Ritik4388/RV32I-PIPELINED-RTL-TO-GDSII/riscv-dv/testlist.yaml

- test: riscv_arithmetic_basic_test
  description: ALU only, numeric corner cases (0, -1, MIN, MAX...)
  gen_opts: >
    +instr_cnt=5000
    +num_of_sub_program=0
    +directed_instr_0=riscv_int_numeric_corner_stream,4
    +no_fence=1 +no_data_page=1 +no_branch_jump=1
    +boot_mode=m +bare_program_mode=1 +no_csr_instr=1
    +no_ebreak=1 +no_wfi=1 +no_dret=1
  iterations: 2
  gen_test: riscv_instr_base_test
  rtl_test: core_base_test

- test: riscv_rand_instr_test
  description: random mix incl. load/store streams and branches
  gen_opts: >
    +instr_cnt=5000
    +num_of_sub_program=5
    +directed_instr_0=riscv_load_store_rand_instr_stream,4
    +directed_instr_1=riscv_loop_instr,4
    +directed_instr_2=riscv_hazard_instr_stream,4
    +directed_instr_3=riscv_load_store_hazard_instr_stream,4
    +directed_instr_4=riscv_multi_page_load_store_instr_stream,4
    +directed_instr_5=riscv_mem_region_stress_test,4
    +directed_instr_6=riscv_jal_instr,4
    +no_fence=1
    +boot_mode=m +bare_program_mode=1 +no_csr_instr=1
    +no_ebreak=1 +no_wfi=1 +no_dret=1
  iterations: 3
  gen_test: riscv_instr_base_test
  rtl_test: core_base_test

- test: riscv_jump_stress_test
  description: lots of JAL / JALR - stresses BTB and redirect logic
  gen_opts: >
    +instr_cnt=5000
    +num_of_sub_program=5
    +directed_instr_1=riscv_jal_instr,20
    +no_fence=1
    +boot_mode=m +bare_program_mode=1 +no_csr_instr=1
    +no_ebreak=1 +no_wfi=1 +no_dret=1
  iterations: 2
  gen_test: riscv_instr_base_test
  rtl_test: core_base_test

- test: riscv_loop_test
  description: nested loops - stresses the BHT counters
  gen_opts: >
    +instr_cnt=10000
    +num_of_sub_program=5
    +directed_instr_1=riscv_loop_instr,20
    +no_fence=1
    +boot_mode=m +bare_program_mode=1 +no_csr_instr=1
    +no_ebreak=1 +no_wfi=1 +no_dret=1
  iterations: 2
  gen_test: riscv_instr_base_test
  rtl_test: core_base_test

- test: riscv_rand_jump_test
  description: jumps between many sub-programs
  gen_opts: >
    +instr_cnt=10000
    +num_of_sub_program=10
    +directed_instr_0=riscv_load_store_rand_instr_stream,8
    +no_fence=1
    +boot_mode=m +bare_program_mode=1 +no_csr_instr=1
    +no_ebreak=1 +no_wfi=1 +no_dret=1
  iterations: 2
  gen_test: riscv_instr_base_test
  rtl_test: core_base_test
