Ritik4388/RV32I-PIPELINED-RTL-TO-GDSII/rtl/alu.sv

module alu
  import riscv_pkg::*;
(
  input  alu_op_e     op,
  input  logic [31:0] a, b,
  output logic [31:0] y
);
  always_comb begin
    unique case (op)
      ALU_ADD:  y = a + b;
      ALU_SUB:  y = a - b;
      ALU_SLL:  y = a << b[4:0];
      ALU_SLT:  y = {31'b0, $signed(a) < $signed(b)};
      ALU_SLTU: y = {31'b0, a < b};
      ALU_XOR:  y = a ^ b;
      ALU_SRL:  y = a >> b[4:0];
      ALU_SRA:  y = $unsigned($signed(a) >>> b[4:0]);
      ALU_OR:   y = a | b;
      ALU_AND:  y = a & b;
      default:  y = a + b;
    endcase
  end
endmodule
